danshoujieyi/Temperature-logger/README.md

# Temperature-logger
基于NXP LPC1114的温度记录仪

本文详细介绍了基于 LPC1114 微控制器的温度记录仪设计。该设计旨在综 
合运用嵌入式软硬件知识，实现环境温度的实时采集、存储、显示与报警功能。 
硬件方面，以 LPC1114 为核心，集成了 LM75BD 温度传感器、XT25 闪存、DS1307 
时钟、OLED 显示屏、蓝牙串口、蜂鸣器等模块，并采用模块化设计与紧凑 PCB 布 
局，支持 USB 和电池双供电。软件上，基于 C 语言在 Keil MDK 环境开发，通 
过定时器中断实现每秒温度采集、显示刷新与数据存储，利用中位数滤波算法处 
理温度数据，同时具备串口通信、温度超限报警及 RGB 灯指示功能。经测试， 
该温度记录仪能在 -55℃至 125℃范围内精确采集温度（精度达 ±1.5℃），存 
储容量不低于 2MB，且在硬件与软件协同工作上稳定可靠，有效解决了温度监测 
与记录的实际应用需求，同时也针对开发过程中的问题进行了优化与改进，为后 
续嵌入式系统设计积累了宝贵经验。。
