danshoujieyi/Temperature-logger/(list of files, drawings)

Other design files:
嘉立创标准版PCB工程/PCB_PCB_温度记录仪-刘嘉俊_2025-01-02.json
嘉立创标准版PCB工程/SCH_温度记录仪-刘嘉俊_2025-01-02.json
