danshoujieyi/Temperature-logger/LPC1114/COMMON/SRC/characterlib.c

/****************************************Copyright (c)****************************************************
**                            Guangzhou ZHIYUAN electronics Co.,LTD.
**
**                                 http://www.embedtools.com
**
**------File Info-----------------------------------------------------------------------------------------
** File name:               characterlib.h
** Latest modified Date:    2007-12-12
** Latest Version:          1.0
** Descriptions:            自定义字库 字模数表
**
**--------------------------------------------------------------------------------------------------------
** Created by:              张展威
** Created date:            2007-12-12
** Version:                 1.0
** Descriptions:
**
**--------------------------------------------------------------------------------------------------------
** Modified by:
** Modified date:
** Version:
** Descriptions:
**
*********************************************************************************************************/


#ifndef __GBLIB_H
#define __GBLIB_H
#include "hx16.h"
/*********************************************************************************************************
汉字字模表
汉字库: 宋体16.dot 横向取模,数据排列:从左到右从上到下
*********************************************************************************************************/
const FNT_GB16 GBHZ_16[] = {
    
    "贞",
	0x01,0x00,0x01,0x00,0x01,0xFC,0x01,0x00,0x01,0x00,0x1F,0xF0,0x10,0x10,0x11,0x10,
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
};


#endif
/*********************************************************************************************************
** End of File
*********************************************************************************************************/
