danshoujieyi/Temperature-logger/LPC1114/COMMON/INC/TYPE.H

/******************** (C) COPYRIGHT 2010 Embest Info&Tech Co.,LTD. ************
* 文件名: type.h
* 作者  : Wuhan R&D Center, Embest
* 日期  : 01/18/2010
* 描述  : 类型定义头文件
*******************************************************************************
*******************************************************************************
* 历史:
* 01/18/2010		 : V1.0		   初始版本
*******************************************************************************/

#ifndef __TYPE_H__
#define __TYPE_H__

/* Private typedef -----------------------------------------------------------*/
/* 精确宽度有符号整数类型*/
typedef   signed          char int8_t;
typedef   signed short     int int16_t;
typedef   signed           int int32_t;
typedef   signed       __int64 int64_t;

    /* 精确宽度无符号整数类型 */
typedef unsigned          char uint8_t;
typedef unsigned short     int uint16_t;
typedef unsigned           int uint32_t;
typedef unsigned       __int64 uint64_t;

/* Private define ------------------------------------------------------------*/
#ifndef NULL
#define NULL    ((void *)0)
#endif

#ifndef FALSE
#define FALSE   (0)
#endif

#ifndef TRUE
#define TRUE    (1)
#endif

/* Private macro -------------------------------------------------------------*/
/* Private variables ---------------------------------------------------------*/
/* Private function prototypes -----------------------------------------------*/
/* Private functions ---------------------------------------------------------*/
#endif  /* __TYPE_H__ */

/**
  * @}
  */ 

/**
  * @}
  */ 
/************* (C) COPYRIGHT 2010 Wuhan R&D Center, Embest *****文件结束*******/
