danshoujieyi/Temperature-logger/LPC1114/UART/test.h

#ifndef __TEST_H
#define __TEST_H

 #include "lpc11xx.h"
#include "u8g2.h"

void testDrawProcess(u8g2_t *u8g2);
void testShowFont(u8g2_t *u8g2);
void testDrawFrame(u8g2_t *u8g2);
void testDrawRBox(u8g2_t *u8g2);
void testDrawCircle(u8g2_t *u8g2);
void testDrawFilledEllipse(u8g2_t *u8g2);
void testDrawMulti(u8g2_t *u8g2);
void testDrawXBM(u8g2_t *u8g2);

void u8g2DrawTest(u8g2_t *u8g2);

#endif
