danshoujieyi/Temperature-logger/(commit log)

2025-01-01 第一次提交
    [PCB_PCB_温度记录仪-刘嘉俊_2025-01-02.json, SCH_温度记录仪-刘嘉俊_2025-01-02.json]
2025-01-19 第二次提交，更新设计报告
