danshoujieyi/Temperature-logger/(notices)

Notices in the files:
LPC1114/COMMON/INC/TYPE.H:
(C) COPYRIGHT 2010 Wuhan R&D Center, Embest *****ÎÄ¼þ½áÊø
